jaimebuildsthings/corner-balancer/hardware/README.md

# Hardware

Mechanical design and printable parts.

- [`full-size-pad/`](full-size-pad/): phase 2 car pad, ~2,000 kg (OpenSCAD source, renders; draft)

The phase 1 bench pad is described in [docs/assembly.md](../docs/assembly.md).

Hardware designs in this folder are licensed under [CERN-OHL-P-2.0](LICENSE).
