jaimebuildsthings/corner-balancer/docs/scales-protocol.md

# Scales protocol

How an app (for example a web page) reads the scales. One JSON object per line, the same on every transport.

**Contents:** [Transports](#transports) · [Frames](#weights-frame) · [Commands](#commands) · [Web Serial example](#web-serial-example) · [Versioning](#versioning)

## Transports

| Transport | Status | Works in |
| --- | --- | --- |
| USB serial, 115200 baud | ✅ Now | Chrome/Edge desktop via Web Serial; any serial terminal |
| WebSocket `ws://192.168.4.1/ws` on the host pad's Wi-Fi | ✅ Now | Any browser on that network (used by the built-in page). Frames as text messages; commands sent as text messages |
| Bluetooth LE | ⏳ Planned | Chrome on Android/desktop via Web Bluetooth (not iOS Safari) |

Connect to **any pad**: each one hears the others over ESP-NOW and reports all of them.

## Weights frame

Send `json on` and the pad prints a frame 5×/s:

```json
{"v":1,"type":"weights","t_ms":184200,"pads":[
  {"name":"9a91a8","corner":"LF","kg":312.400,"stable":true,"calibrated":true,"age_ms":0},
  {"name":"4c11e0","corner":"RF","kg":298.100,"stable":true,"calibrated":true,"age_ms":40}
]}
```

(One line on the wire; wrapped here.)

| Field | Meaning |
| --- | --- |
| `v` | Protocol version (1) |
| `type` | `"weights"` (the only type so far; ignore unknown types) |
| `t_ms` | Milliseconds since the sending pad booted |
| `pads[].name` | The pad's name: last 6 hex digits of its MAC, printed on the pad |
| `pads[].corner` | `"LF"`, `"RF"`, `"LR"`, `"RR"`, or `null` if not assigned |
| `pads[].kg` | Weight after calibration and tare. **Counts, not kg, if `calibrated` is false.** `null` if invalid |
| `pads[].stable` | The reading has settled. Wait for all four before trusting cross weight |
| `pads[].calibrated` | The pad has a calibration |
| `pads[].age_ms` | How old this pad's reading is. Pads silent for over 2 s are left out |

Corner math is left to the app: total, front %, left %, cross = (LF + RR) / total.

If two pads report the same `corner` (one was off when the corner was reassigned), treat that corner as unknown and ask the user to run `assign` again; the firmware does the same in its totals.

Other serial output (console replies, CSV) shares the port. **Parse only lines that start with `{`.**

## Commands

Send console commands as text lines ending in `\n`:

| Command | Effect |
| --- | --- |
| `json on` / `json off` | Start / stop frames |
| `tare` / `tare all` | Zero the connected pad / every pad at its next settled reading |
| `assign LF` | Press-to-assign: the next pad pressed (≥ 2 kg rise) becomes LF |
| `assign LF 9a91a8` | Assign a corner directly by pad name |
| `unassign LF` | Free a corner |
| `blink 9a91a8` / `blink LF` | Flash a pad's LED |
| `pads` | Human-readable table (not JSON) |

During press-to-assign, watch `corner` in the frames to see the result. Console replies are plain text, not JSON.

## Web Serial example

```js
const port = await navigator.serial.requestPort();
await port.open({ baudRate: 115200 });

const writer = port.writable.getWriter();
await writer.write(new TextEncoder().encode("json on\n"));
writer.releaseLock();

const lines = port.readable
  .pipeThrough(new TextDecoderStream())
  .pipeThrough(new TransformStream({
    start() { this.buf = ""; },
    transform(chunk, ctl) {
      this.buf += chunk;
      const parts = this.buf.split(/\r?\n/);
      this.buf = parts.pop();
      parts.forEach((l) => ctl.enqueue(l));
    },
  }));

for await (const line of lines) {
  if (!line.startsWith("{")) continue;
  const frame = JSON.parse(line);
  if (frame.v !== 1 || frame.type !== "weights") continue;
  const kg = Object.fromEntries(
    frame.pads.filter((p) => p.calibrated && p.corner).map((p) => [p.corner, p.kg]),
  );
  // kg.LF, kg.RF, kg.LR, kg.RR
}
```

## Versioning

- New fields may be added within version 1; ignore fields you don't know.
- Removing or changing the meaning of a field bumps `v`.
- Source of truth: [`protocol::json`](../firmware/crates/protocol/src/json.rs).
