jaimebuildsthings/corner-balancer/docs/bom.md

# Bill of materials

Prices are approximate, Oct 2026. Tools not included (soldering iron, multimeter, drill, calipers).

**Contents:** [Phase 1a](#phase-1a-one-bench-pad) · [Phase 1b](#phase-1b-second-pad) · [Later phases](#later-phases)

## Phase 1a: one bench pad

About $115–200 in total.

**Electronics**

| Part | Qty | ~Price | Notes |
| --- | --- | --- | --- |
| 50 kg half-bridge cells with brackets + 2 generic HX711 (e.g. DIYmalls 8-pack) | 1 kit | $15–25 | 4 for the pad, 4 for pad B |
| SparkFun Load Sensor Combinator (BOB-13878) | 1 | $7 | Bridge wiring on a PCB |
| SparkFun Load Cell Amplifier HX711 | 1 | $11 | Separate analog/logic supplies |
| ESP32-S3-DevKitC-1 clone, N16R8 | 2–3 | $19 / 3 | Pad A and pad B |
| DS18B20 waterproof probes | 5-pack | $10 | One per pad |
| Shielded Cat6 cable (1–2 m) + 2 RJ45 jacks | 1 set | $10–15 | Label "NOT ETHERNET" |
| ABS box ~100 × 70 × 40 mm + PG7 glands | 2 | $10–15 | |
| Hookup wire, heat-shrink, perfboard, screw terminals | | $10 | |
| USB power bank or 5 V supply | 1–2 | $0–30 | |
| 4.7 kΩ resistor | 1 per probe | | DS18B20 pull-up |

**Mechanical**

| Part | Qty | ~Price | Notes |
| --- | --- | --- | --- |
| 12 mm Baltic birch, 300 × 300 mm | 2 | $15–25 | Top and base |
| M6 bolts, nuts, threaded inserts | 4 sets | $5–10 | Overload stops |
| Dowel pin or shoulder bolt | 1 | $2 | Locating pin |
| Rubber feet | 4 | $5 | |
| Wood screws, epoxy or VHB, blue threadlocker | | $15 | |

**Testing:** reference weights (gym plates, dumbbells), each verified on a known scale.

## Phase 1b: second pad

| Part | Qty | ~Price | Notes |
| --- | --- | --- | --- |
| Second 8× 50 kg cell kit | 1 | $15–25 | Spares; the first kit's 8 cells all go into the 2 pads |
| SparkFun Combinator + SparkFun HX711 | 1 each | $18 | Matches pad A |
| 12 mm Baltic birch, 300 × 300 mm | 2 | $15–25 | |
| Shielded Cat6 + 2 RJ45 jacks | 1 set | $10–15 | |
| Stop hardware, locating pin, feet | | $15 | As pad A |
| Stiff plank, ~1 m | 1 | | Lever-rule test |

## Later phases

Phase 2 (one ~2,000 kg pad) and phase 3 (four pads) parts are chosen after gate 1. See [plan.md](plan.md).
