jaimebuildsthings/corner-balancer/(commit log)

2026-10-14 docs: add prototype plan and diagrams
    Plan revised after review: phase 1 split into 1a (one pad, serial)
    and 1b (two pads, ESP-NOW, phone UI), no dedicated hub board,
    HX711 VCC/VDD split, license split, two-pad lever-rule test.
2026-10-14 firmware: add scale crate with host tests
    no_std, dependency-free signal chain: median-of-5 then EMA filter,
    stability flag, tare kept in counts so it survives recalibration,
    multi-point least-squares calibration with residuals and a versioned
    flash encoding, corner-weight and two-pad split math, and the bench
    test protocol (noise, place/remove, creep) with targets scaled to
    full-scale rating.
2026-10-14 firmware: add protocol crate: pad message, CSV rows, console commands
    PadMsg is a 19-byte versioned little-endian frame with magic bytes so
    stray ESP-NOW traffic is rejected. CSV rows match the documented
    header. The console command parser covers tare, calibration, streaming
    and the bench tests, acting on a selected channel.
2026-10-14 firmware: add hx711 bit-bang driver on embedded-hal 1.0
    Reads 24 bits plus gain pulses inside a critical section so no SCK
    high pulse can stretch past the 60 us power-down threshold. Tests run
    against a simulated chip that checks bit order, sign extension, pulse
    count per gain and SCK high time.
    Deps: embedded-hal 1.0.0, critical-section 1.2.0 (MIT OR Apache-2.0).
2026-10-14 firmware: add crash-safe flash record format to protocol crate
    Two-slot records with magic, sequence number, length and CRC-32. The
    writer always targets the older slot, so a power cut mid-write leaves
    the previous calibration intact. Replaces the planned sequential-storage
    dependency.
2026-10-14 firmware: add ds18b20 one-wire driver
    Single probe per pin, Skip ROM addressing, conversion split into start
    and read so the firmware can await the 750 ms conversion. Each bit slot
    runs in a short critical section. Scratchpad CRC-8 and temperature
    decoding are host-tested against datasheet values.
2026-10-14 firmware: add pad binary for ESP32-S3 and ESP32
    Core 1 samples the HX711 into a channel; core 0 filters, runs the serial
    console (UART0) with echo, the bench tests, CSV streaming and the
    DS18B20. Calibration is stored in the calib partition with the two-slot
    record format; flash writes auto-park core 1. A partition table with
    two OTA slots fits 4 MB boards. The sim feature replaces the HX711 with
    a synthetic 0/20 kg signal for boards without load cells.
    Deps: esp-hal 1.2, esp-rtos 0.4, esp-bootloader-esp-idf 0.6,
    esp-println 0.18, esp-storage 0.10, embassy-executor/time/sync,
    critical-section, static_cell (all MIT OR Apache-2.0).
    [partitions.csv]
2026-10-14 firmware: fix stability before calibration; quiet echo while streaming
    An uncalibrated pad applied the 0.05 kg stability band to raw counts,
    so it never reported stable and `cal add` waited forever. Stability is
    now tracked on filtered counts, with a separate counts band until the
    pad is calibrated. While CSV is streaming, keystrokes are no longer
    echoed into the rows; the line is echoed once on Enter. `status` shows
    counts, not a fake kg value, for an uncalibrated pad.
    Found on the first ESP32 sim run.
    [app.rs, console.rs]
2026-10-14 firmware: add `sim KG` command; noise test waits for a stable start
    The simulator's 15 s auto-switching made interactive calibration and
    the noise test race the phase change (first ESP32 run recorded the
    0 and 20 kg points swapped, and a noise test straddled a step). The
    simulated load is now set from the console and defaults to 0 kg.
    NoiseTest ignores readings until the first stable one.
    [app.rs, sampler.rs]
2026-10-14 firmware: cal add and test zero only accept readings taken after the command
    Right after a load change the filter can still report the old value as
    stable for a sample or two. Both now wait until a full stability window
    (plus the median delay) has passed since the command.
    [app.rs]
2026-10-14 firmware: tare waits for a settled reading
    Taring right after a load change zeroed on a value still settling
    (first ESP32 run: -47 g offset after tare). Tare now applies at the
    first stable reading taken after the command, like cal add.
2026-10-14 firmware: redraw the half-typed console line around messages
    Messages printed while a command was being typed (e.g. "tared at ...")
    landed in the middle of it. Output lines now clear the half-typed line
    and redraw it afterwards.
2026-10-14 ci: host tests and firmware builds; flashable images on tags
    Host job: fmt, clippy, tests for the hardware-independent crates.
    Firmware job: clippy and release build for ESP32-S3 and ESP32, with
    and without sim. On v* tags it saves app-only and merged (0x0) images
    as artifacts. Uses only GitHub's own actions, pinned by commit, plus
    pinned espup/espflash release binaries. TODO: ESP Web Tools page.
2026-10-14 docs: split wiring, assembly, test protocol and parts list out of the plan
    Wiring adds the RJ45 pinout (excitation and signal on their own twisted
    pairs), the HX711 split supply and per-board pin tables. The test
    protocol maps each test to its console command and adds the two-pad
    lever-rule test. Diagrams are embedded where they belong.
2026-10-14 tools: add offline plot page for captured test runs
    Drop a monitor capture onto tools/plot.html to plot kg and temperature
    per channel and the last cal fit's residuals. Stats (mean, std dev,
    spread, drift) follow the zoomed range, so zero noise and creep can be
    read off directly. uPlot 1.6.32 (MIT) is vendored with its license.
2026-10-14 protocol: add id/pads commands and ESP-NOW link statistics
    LinkStats counts lost messages from sequence gaps and the longest gap
    between arrivals, treating a sequence reset as a sender restart.
    [link.rs]
2026-10-14 firmware: exchange readings between pads over ESP-NOW
    Every pad broadcasts a PadMsg for channel 0 on each reading (10/s) on a
    fixed channel and listens for the others; no pairing. The pad ID is set
    with `id N` and saved in the calib record (older records still load).
    `pads` lists each pad's weight, stability, age, packet loss and longest
    gap, plus the two-pad split or the four-pad corner figures. Duplicate
    IDs are reported.
    Deps: esp-radio =1.0.0-beta.1 and esp-alloc 0.11 (MIT OR Apache-2.0);
    Espressif's radio libraries come in via esp-wifi-sys (Apache-2.0
    binaries). Full dependency tree checked: no copyleft licenses.
    [app.rs, calib_store.rs, link.rs, main.rs]
2026-10-14 protocol: add the scales protocol (JSON lines) and json command
    One weights frame per line: version, type, time, and per pad the id
    (0-3 = LF, RF, LR, RR), kg, stable, calibrated and age. Meant for apps
    such as stringline.ing over Web Serial now and Web Bluetooth later.
2026-10-14 firmware: send scales-protocol frames with `json on`
    Five frames a second covering this pad and every fresh pad heard over
    ESP-NOW. Keystroke echo stays quiet while frames flow so lines stay
    parseable. Output lines can now be up to 512 bytes.
2026-10-14 protocol: pad names, corners, inter-pad commands and press-to-assign
    Pads are named by the last three bytes of their MAC address and carry
    an optional corner (LF/RF/LR/RR) instead of a numeric ID. A CmdMsg
    frame carries assign/tare/blink between pads, sent several times and
    deduplicated by (sender, id). Assigning a corner takes it from any other
    pad. Console: assign CORNER [PAD], assign stop, unassign, blink,
    tare all; `id` is gone. JSON frames now report name and corner.
2026-10-14 firmware: name pads by MAC, assign corners by pressing, blink, tare all
    Pads are tracked by MAC and named by its last six hex digits. The saved
    setting is now a corner (older pad IDs 0/1 load as LF/RF). `assign LF`
    watches every pad's weight and gives LF to the one pressed (>= 2 kg
    rise, exactly one pad), then blinks it. Assignments, tare and blink go
    to other pads as CmdMsg frames over ESP-NOW; whichever pad held a
    corner gives it up. `pads` and JSON frames show names and corners, and
    totals are computed per corner.
2026-10-14 firmware: BOOT button simulates pressing on a pad (sim builds)
    Holding BOOT (GPIO0 on ESP32 and ESP32-S3) adds 20 kg to the simulated
    load, so press-to-assign can be tried on bare boards.
2026-10-14 firmware: flag corners claimed by two pads and leave them out of totals
    A pad that was off during an assign keeps its old corner. Totals used
    to silently take whichever claim came first; now `pads` prints a
    CONFLICT line, the corner is excluded, and a pad warns once when
    another pad claims its corner.
2026-10-15 Web UI on the host pad's own Wi-Fi (#3)
    * protocol: add host on|off command
    * web: phone UI page with live corners, tare, assign walk-through, CSV log
    One dependency-free HTML file, embedded in the firmware. It reads
    scales-protocol frames over a WebSocket and sends console commands
    back. Assigning corners is a walk-through: the page watches every pad's
    weight, finds the one pressed and sends an explicit assign, so a pad
    that is already right is handled too. ?mock (or opening the file
    directly) runs on simulated pads.
    * firmware: host pad serves the web UI on its own Wi-Fi net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
2026-10-17 hardware: draft OpenSCAD model of the full-size pad
    [pad.scad]
